ndezelak/self_balancing_robot/Mechanics/wheel.PNG

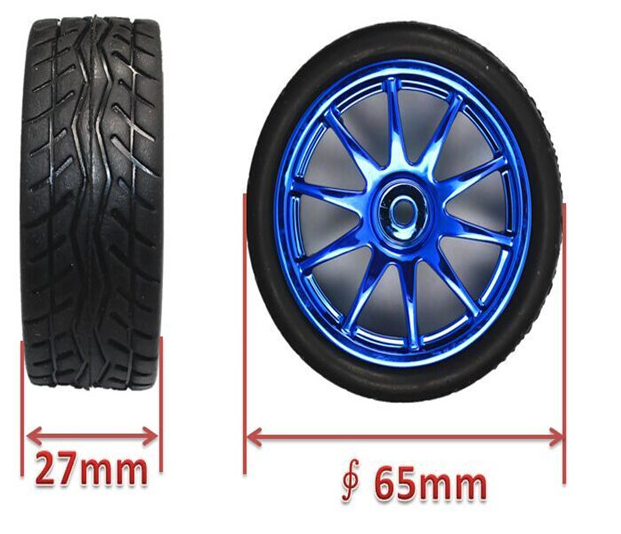
Mechanics/wheel.PNG
