ndezelak/self_balancing_robot/Mechanics/Link_to_wheels.txt

https://www.ebay.de/itm/DC-12V-Encoder-Gear-Motor-4mm-Shaft-with-Mounting-Bracket-65mm-Wheel-Kit/232476321585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

--------------------------------------
https://www.ebay.de/itm/12V-320rpm-12V-107rpm-6V-160rpm-DC-Zahnrad-Motor-Encoder-mit-mounting-Bracke/273153671183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
