ndezelak/self_balancing_robot/Actuation/motor.PNG

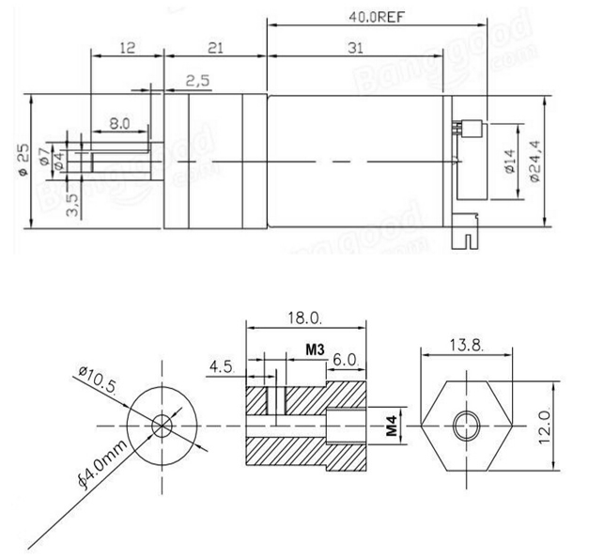
Actuation/motor.PNG
