ndezelak/self_balancing_robot/Actuation/motor_and_encoder_specs.PNG

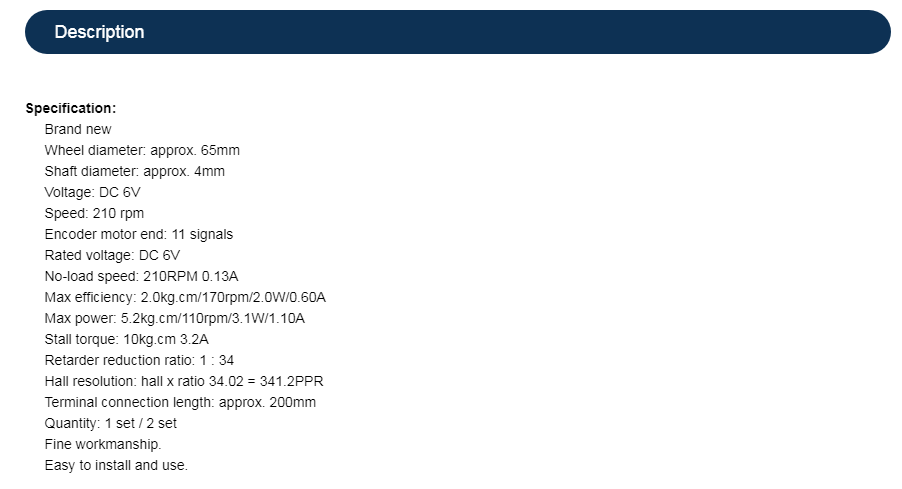
Actuation/motor_and_encoder_specs.PNG
