ndezelak/self_balancing_robot/General/bill_of_materials.xlsx

Self-balancing robot bill of materials | Quantity | Price | Links
Brushed DC motor with gearbox, encoder, wheel and mounting bracket | 2 | 11.99 € |  |  | Project cost: | 114.68 €
LiPo Battery 4200 mAh 25C 7.4 V | 1 | 14 € |  |  | To be payed: | 88.69 €
LiPo Charger |  |  |  | 11.55 €
LTC4002-8.4 | 1 | 3.05 € | LINK (https://www.mouser.de/ProductDetail/Analog-Devices-Linear-Technology/LTC4002ES8-84PBF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) | 3.05 €
PMOSFET | 1 | 0.29 € | LINK (https://www.mouser.de/ProductDetail/Diodes-Incorporated/DMP3099L-7) | 0.29 €
Schottky Diode | 2 | 0.30 € | LINK (https://www.mouser.de/ProductDetail/Diodes-Incorporated/B340-13-F) | 0.60 €
C_in = 10uF 25V | 1 | 0.25 € | LINK (https://www.mouser.de/ProductDetail/Taiyo-Yuden/TMK316BJ106KL-T) | 0.25 €
C_out = 22uF 16V | 1 | 0.51 € | LINK (https://www.mouser.de/ProductDetail/Murata-Electronics/GRT21BR61C226ME13L) | 0.51 €
L = 5uH | 1 | 1.71 € | LINK (https://www.mouser.de/ProductDetail/Panasonic/ELL-ATV5R1N) | 1.71 €
R_sense = 50m | 1 | 0.45 € | LINK (https://www.mouser.de/ProductDetail/Welwyn-Components-TT-Electronics/LRC-LR1206LF-01-R050-F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) | 0.45 €
C_comp = 0.47uF 16V | 1 | 0.09 € | LINK (https://www.mouser.de/ProductDetail/Wurth-Electronics/885012207049) | 0.09 €
R_comp = 2.2k | 1 | 0.09 € | LINK (https://www.mouser.de/ProductDetail/Vishay-Draloric/RCG08052K20JNEA) | 0.09 €
R_led = 1k | 1 | 0.09 € | LINK (https://www.mouser.de/ProductDetail/Vishay-Draloric/RCG08051K00JNEA) | 0.09 €
LED Red | 1 | 0.34 € | LINK (https://www.mouser.de/ProductDetail/ROHM-Semiconductor/SML-811UTT86C) | 0.34 €
LDOs |  |  |  | 2.94 €
3.3V LDO | 3 | 0.38 € | LINK (https://www.mouser.de/ProductDetail/STMicroelectronics/LDL1117S33R) | 1.14 €
5V LDO | 3 | 0.38 € | LINK (https://www.mouser.de/ProductDetail/STMicroelectronics/LDL1117S50R) | 1.14 €
C_out = 4.7uF | 3 | 0.11 € | LINK (https://www.mouser.de/ProductDetail/Wurth-Electronics/885012107013) | 0.33 €
C_in = 1uF | 3 | 0.11 € | LINK (https://www.mouser.de/ProductDetail/KEMET/C0805C105Z4VACTU) | 0.33 €
Passive Balancer |  |  |  | 1.73 €
optocoupler 2 channel | 1 | 0.83 € | LINK (https://www.mouser.de/ProductDetail/Broadcom-Avago/ACPL-227-500E) | 0.83 €
R_disch 100ohm >250mW | 2 | 0.13 € | LINK (https://www.mouser.de/ProductDetail/ROHM-Semiconductor/ESR18EZPF1000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) | 0.26 €
NMOSFET transistor 2 channel | 1 | 0.22 € | LINK (https://www.mouser.de/ProductDetail/Toshiba/SSM6N7002KFULF) | 0.22 €
R_led 250ohm >625mW | 2 | 0.21 € | LINK (https://www.mouser.de/ProductDetail/Panasonic/ERJ-12ZYJ241U) | 0.42 €
Motor drive |  |  |  | 4.62 €
TI DRV8871 | 2 | 1.96 € | LINK (https://www.mouser.de/ProductDetail/Texas-Instruments/DRV8871DDAR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) | 3.92 €
R_ilim 20k | 2 | 0.09 € | LINK (https://www.mouser.de/ProductDetail/Panasonic-Industrial-Devices/ERJ-6ENF2002V) | 0.18 €
C_bulk 47uF | 2 | 0.16 € | LINK (https://www.mouser.de/ProductDetail/Lelon/VE-470M1CTR-0505) | 0.32 €
C_bypass 0.1uF | 2 | 0.10 € | LINK (https://www.mouser.de/ProductDetail/Vishay-Vitramon/VJ1206Y104MXJCW1BC) | 0.20 €
Sensors |  |  |  | 17.90 €
SparkFun 9DoF Sensor Stick | 1 | 14.95 € | LINK (https://eckstein-shop.de/SparkFun-9DoF-Sensor-Stick) | 14.95 €
Ultrasonic sensor HC-SR04 | 1 | 2.95 € | LINK (https://eckstein-shop.de/HC-SR04-Abstandsmessung-Ultraschall-Ultrasonic-Sensor-Module) | 2.95 €
MCU |  |  |  | 28.84 €
STM32F030RC | 3 | 2.62 € | LINK (https://www.mouser.de/ProductDetail/STMicroelectronics/STM32F030RCT6) | 7.86 €
Voltager regulator 3.3V | 3 | 0.79 € | LINK (https://www.mouser.de/ProductDetail/Torex-Semiconductor/XC6902N331MR-G) | 2.36 €
C_bypass 0.1uF | 10 | 0.10 € | LINK (https://www.mouser.de/ProductDetail/Vishay-Vitramon/VJ1206Y104MXJCW1BC) | 1.00 €
C_bypass_0.01uF | 5 | 0.03 € | LINK (https://www.mouser.de/ProductDetail/Wurth-Electronics/885012105001) | 0.15 €
C_bypass_1uF | 5 | 0.11 € | LINK (https://www.mouser.de/ProductDetail/KEMET/C0805C105Z4VACTU) | 0.55 €
C_bypass_47uF | 10 | 0.11 € | LINK (https://www.mouser.de/ProductDetail/Wurth-Electronics/885012107013) | 1.10 €
10-pin SWD cable | 1 | 2.58 € | LINK (https://www.mouser.de/ProductDetail/Adafruit/1675) | 2.58 €
10-pin SWD board connector | 2 | 0.66 € | LINK (https://www.mouser.de/ProductDetail/Amphenol-FCI/20021121-00010C4LF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) | 1.32 €
ST-LINKv2 programmer | 1 | 10.92 € | LINK | 10.92 €
pushbutton | 4 | 0.25 € | LINK (https://www.mouser.de/ProductDetail/Grayhill/95C04B3GWRT?qs=sGAEpiMZZMuoocfCme37cvwSktETNPw6n9Oj0YRWbEk%3d) | 1.00 €
Quarz 32MHz | 3 | 0.30 € | LINK (https://www.mouser.de/ProductDetail/ABRACON/ABL-32000MHZ-B2) | 0.90 €
C_quartz 22pF | 6 | 0.09 € | LINK (https://www.mouser.de/ProductDetail/Wurth-Electronics/885012007002) | 0.54 €
R_pullup 10k | 3 | 0.19 € | LINK (https://www.mouser.de/ProductDetail/Vishay-Beyschlag/MCU08050C1002FP500) | 0.57 €
Bluetooth interface |  |  |  | 9.00 €
HC-06 | 3 | 3.00 € | LINK (https://www.ebay.com/itm/HC-06-Wireless-Bluetooth-Arduino-PI-JY-MCU-Serial-RF-5V-Transeiver-Module-US/272770538673) | 9.00 €
Connectors |  |  |  | 12.11 €
pin header 4-pin 1 row female (50 packet) | 1 | 1.15 € | LINK (https://www.mouser.de/ProductDetail/Harwin/M20-7820446) | 1.15 €
pin header 4-pin 1 row male 90 degrees (12 packet) | 1 | 0.87 € | LINK (https://www.mouser.de/ProductDetail/Molex/90121-0124) | 0.87 €
[Battery] T-connector male | 3 | 0.83 € | LINK (https://www.mouser.de/ProductDetail/SparkFun/PRT-11864) | 2.49 €
[Charger] 12V barrel connector | 3 | 0.92 € | LINK (https://www.mouser.de/ProductDetail/CUI/PJ-076B) | 2.76 €
[Battery] JST-XH 3.pin female connector (100 pairs packet) | 1 | 2.84 € | LINK (https://www.ebay.com/itm/100-Pairs-2-3-4-6Pin-10p-JST-XH-2-54MM-Male-Female-Right-Angle-connector-for-PCB/272918813557) | 2.84 €
[Motor]20 pack JST-PH 6-pin female + male | 1 | 2.00 € | LINK (https://www.ebay.com/itm/Micro-JST-PH2-0-Right-Angle-2-5-6-8Pin-Wire-To-Board-Connector-20cm-W-Socket/152880295768) | 2.00 € | Will be soldered together with existing wires!
