ndezelak/self_balancing_robot/(list of files, cad)

Other CAD files:
Mechanics/3D_model.skp
