ndezelak/self_balancing_robot/Power Management/balancer_driver.asc

M1: nmos; Si7540DP_N
R1: res; 100
R2: res; 250
U1: PC817D
V1: voltage; 12; Rser=10m
V2: voltage; PULSE(0 3.3 0 1n 1n 1m 2m 5); Rser=10m
V3: voltage; 4.2; Rser=10m
Named nets: 0
.tran 0.5
